dllgxhy/ble_airmouse/requirment/空中鼠标需求描述1017.pptx

## 需求描述

- 低功耗BLE蓝牙方式连接，使用标准HID接口(建议使用Nordic nRF51822)。无须驱动支持windows 8 /10 操作系统，surface 3/pro3，surface4/pro4平板电脑。
- 使用6轴传感器使用空中鼠标功能。并使用nRF51822作为传感器的信号处理MCU。
- 包含功能按键：空中鼠标模式开关，PageUp/PageDown，鼠标左键，windows快捷键组合。
- 满足50mAh的锂离子电池支持连续使用2小时的功耗要求。待机不低于180天时间。
- 蓝牙使用距离应该是在室内无遮挡不低于10米。
- 按照给定尺寸（CAD文件）的作出PCB设计，和原理图设计。

## 功能详细描述 – 用单个功能键完成多个功能

功能键：1个
休眠：静止30秒，停止陀螺仪功能。进入休眠后，必须按动功能键，才能打开陀螺仪。
已连接蓝牙情况下，功能键的定义：
1. 双击：开、关陀螺仪，此时默认鼠标左键放开状态，笔只有光标移动的功能。
2. 单击：启用、定制划线功能。
3. 长按 + 甩动：动作手势 （默认：上、下、左、右、圆弧）
动作手势：
上：空，后续跟进市场反馈添加功能
下：空，后续跟进市场反馈添加功能
左：PPT后退一页
右：PPT前进一页
圆圈：关闭投影
双色功能指示灯：1个
不亮：陀螺仪关闭
红色：固定频率闪亮，陀螺仪打开，预备移动光标功能
红色：常亮，划线功能打开
绿色：保留，我们会分配蓝牙的其他状态到绿灯上。

## 交付件

- 硬件相关：
  - 样品原型板卡
  - PCB layout设计文件
  - 原理图
  - BOM list
  - 生产 Gerber文件
- 软件相关
  - 源代码
  - 对应协议栈文件
  - 软件编译环境配置说明
  - 应用算法原理描述

## 项目计划

- 自项目正式启动，4周内给出蓝牙开发板演示原型，满足功能要求。
- 5周给PCB layout和样品板。（项目启动后一周内需求方提供结构CAD文件，并有结构工程师配合验证）
- 6周输出测试验证报告
