dllgxhy/ble_airmouse/mechnical/ble_gyro_pca_20161214/ble_gyro_pca_20161214/gyroscope_ble_pca_20161214.pptx

Gyroscope pen

蓝牙板尺寸：30*7.8*0.7mm

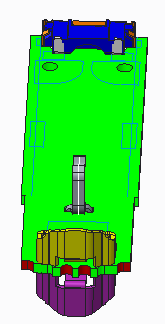
[picture p1: figure]

1. 此4个红色的凹面请覆铜，镀金，为测试机使用的测试点，
2. 烧录，测试时，拒绝在此4个点上锡，可考虑在板上别的位置再开相同的测试点，方便前期（没有测试机时），烧录，测试。

## Slide 2

Gyroscope pen

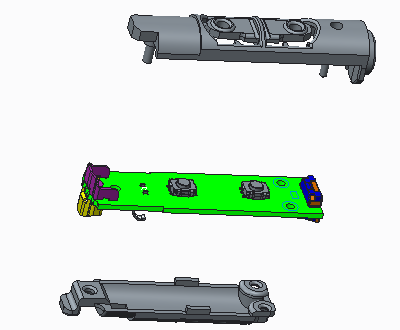
[picture p2: figure]
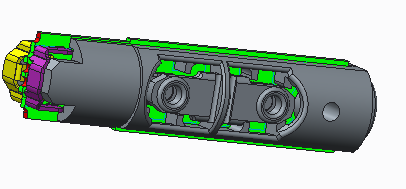
[picture p3: figure]
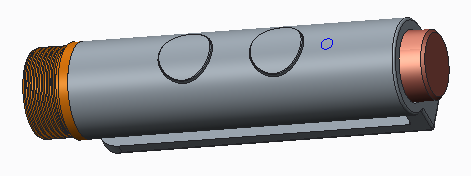
[picture p4: figure]
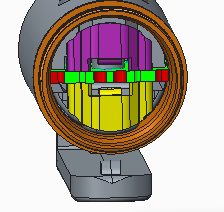
[picture p5: figure]
