dllgxhy/ble_airmouse/plan/蓝牙空鼠研发费用明细表.xls

附件：研发费用明细表
 |  | 蓝牙空鼠研发费用表
 |  | Num | Item List |  | Total Resource | Unit Price (RMB 1000 yuan) | Total Price (RMB 1000 yuan) | Resource Detail
 |  | Total | Item | Resource | 3.3 | - | 60.4 | 1 | 2 | 3 | 4 | 5 | 6 | 7 | 8 | 9 | 10 | 11 | 12
 | 设计成本 | 1 | 硬件电路设计 | 硬件工程师 | 1.10 | 18 | 19.8 |  |  |  |  |  |  |  |  |  | 0.3 | 0.8
 |  | 2 | 硬件电路设计 | PCBLayout工程师 | 0.30 | 14 | 4.2 |  |  |  |  |  |  |  |  |  |  | 0.3
 |  | 3 | 软件设计 | 嵌入式软件工程师 | 1.10 | 20 | 22 |  |  |  |  |  |  |  |  |  | 0.3 | 0.8
 |  | 4 | 软件设计 | 嵌入式软件工程师 | 0.60 | 18 | 10.8 |  |  |  |  |  |  |  |  |  | 0.3 | 0.3
 |  | 7 | Management Charge | Project Manager | 0.20 | 18 | 3.6 |  |  |  |  |  |  |  |  |  | 0.2
 |  | Num | Item List |  | Total Resource | Unit Price (RMB yuan) | Total Price (RMB yuan) |  |  |  | 费用总计 (RMB 1000 yuan)
 |  | Total | Item | Resource | 8 | - | 1645 |  |  |  | 设计费用+生产成本=61.6
 | 生产成本 （一次成本，生产5套费用） | 18 | PCB打板开板费 | PCB打板开板费 | 1 | 800 | 800
 |  | 19 | 物料成本(预估) | 物料 | 5 | 29 | 145
 |  | 20 | PCBA贴片 | PCBA贴片 | 1 | 500 | 500
 |  | 21 | 耗材 | 耗材 | 1 | 200 | 200
