dllgxhy/ble_airmouse/hardware/V10/BLEAIRNOUSE20161231坐标文件.xls

PartType | RefDes | PartDecal | Pins | Layer | Orient. | X | Y | SMD | Glued | Value
MARK | 1 | MARK | 1 | Bottom | 0 | -1.778 | 3.683 | Yes | No | None
MARK | 11 | MARK | 1 | Top | 0 | 1.778 | 3.683 | Yes | No | None
ANT_3 | ANT1 | ANT_3 | 1 | Top | 0 | 23.876 | 3.912 | Yes | No | None
C0402 | C1 | C0402B | 2 | Top | 0 | 23.622 | 0.762 | Yes | No | None
C0402 | C2 | C0402B | 2 | Top | 180 | 17.59 | 4.318 | Yes | No | None
C0402 | C3 | C0402B | 2 | Bottom | 90 | -17.018 | 4.191 | Yes | No | None
C0402 | C4 | C0402B | 2 | Bottom | 180 | -23.876 | 1.778 | Yes | No | None
C0402 | C5 | C0402B | 2 | Bottom | 90 | -19.609 | 1.27 | Yes | No | None
C0402 | C6 | C0402B | 2 | Bottom | 270 | -18.796 | 1.295 | Yes | No | None
C0402 | C7 | C0402B | 2 | Top | 180 | 16.828 | 1.448 | Yes | No | None
C0402 | C8 | C0402B | 2 | Bottom | 0 | -14.478 | 0.889 | Yes | No | None
C0402 | C9 | C0402B | 2 | Bottom | 90 | -18.796 | 2.946 | Yes | No | None
C0402 | C10 | C0402B | 2 | Top | 90 | 13.145 | 2.604 | Yes | No | None
C0402 | C11 | C0402B | 2 | Bottom | 90 | -9.652 | 2.096 | Yes | No | None
C0402 | C12 | C0402B | 2 | Top | 0 | 11.684 | 0.762 | Yes | No | None
C0402 | C13 | C0402B | 2 | Top | 90 | 24.13 | 2.032 | Yes | No | None
C0402 | C14 | C0402B | 2 | Top | 180 | 25.527 | 2.921 | Yes | No | None
C0402 | C15 | C0402B | 2 | Top | 270 | 26.035 | 4.191 | Yes | No | None
C0402 | C17 | C0402B | 2 | Top | 0 | 23.495 | 4.064 | Yes | No | None
C0402 | C18 | C0402B | 2 | Top | 90 | 6.858 | 1.27 | Yes | No | None
C0402 | C19 | C0402B | 2 | Top | 90 | 7.747 | 1.27 | Yes | No | None
C0402 | C20 | C0402B | 2 | Top | 0 | 13.589 | 4.318 | Yes | No | None
C0402 | C21 | C0402B | 2 | Top | 180 | 13.589 | 0.762 | Yes | No | None
SOD723 | D1 | SOD723 | 2 | Top | 270 | 5.969 | 1.27 | Yes | No | None
SOD723 | D2 | SOD723 | 2 | Bottom | 180 | -6.807 | 5.994 | Yes | No | None
BAT-JC | J1 | BAT-JC | 2 | Bottom | 180 | -2.972 | 3.988 | No | No | None
BAT- | J2 | BAT- | 2 | Top | 0 | 7.061 | 3.708 | No | Yes | None
BAT-JC | J3 | BAT-JC | 2 | Top | 0 | 2.972 | 3.404 | No | No | None
DIP4-2_0A | J4 | DIP4-2_0A | 4 | Top | 270 | -0.119 | 3.7 | No | No | None
L0402 | L1 | L0402B | 2 | Top | 270 | 14.034 | 2.604 | Yes | No | None
L0603 | L2 | L0603 | 2 | Top | 90 | 15.24 | 2.413 | Yes | No | None
L0402 | L3 | L0402B | 2 | Top | 270 | 25.146 | 4.191 | Yes | No | None
L0402 | L4 | L0402B | 2 | Top | 270 | 23.114 | 2.032 | Yes | No | None
L0402 | L5 | L0402B | 2 | Top | 180 | 23.495 | 3.302 | Yes | No | None
R0402 | R1 | R0402 | 2 | Top | 180 | 6.795 | 5.969 | Yes | No | None
R0402 | R2 | R0402 | 2 | Bottom | 90 | -8.763 | 3.937 | Yes | No | None
R0402 | R3 | R0402 | 2 | Bottom | 90 | -9.652 | 3.937 | Yes | No | None
R0402 | R4 | R0402 | 2 | Bottom | 270 | -8.763 | 2.083 | Yes | No | None
R0402 | R5 | R0402 | 2 | Bottom | 180 | -15.113 | 4.572 | Yes | No | None
R0402 | R6 | R0402 | 2 | Bottom | 90 | -18.034 | 4.191 | Yes | No | None
R0402 | R9 | R0402 | 2 | Bottom | 0 | -25.298 | 3.683 | Yes | No | None
R0402 | R10 | R0402 | 2 | Bottom | 0 | -25.298 | 2.794 | Yes | No | None
R0402 | R11 | R0402 | 2 | Bottom | 180 | -25.298 | 4.572 | Yes | No | None
R0402 | R12 | R0402 | 2 | Bottom | 0 | -15.113 | 2.794 | Yes | No | None
R0402 | R13 | R0402 | 2 | Bottom | 180 | -15.113 | 3.683 | Yes | No | None
R0402 | R15 | R0402 | 2 | Bottom | 0 | -23.876 | 0.813 | Yes | No | None
SW-3_5X2_7-SMD | SW1 | SW-3_5X2_7-SMD | 6 | Bottom | 0 | -12.195 | 3.723 | Yes | Yes | None
SW-3_5X2_7-SMD | SW2 | SW-3_5X2_7-SMD | 6 | Bottom | 180 | -21.695 | 3.728 | Yes | Yes | None
EVQP4 | SW3 | EVQP4 | 4 | Top | 90 | 27.203 | 3.708 | Yes | Yes | None
TP-1MM | TP1 | TP-1MMB | 1 | Bottom | 0 | -11.735 | 0.279 | Yes | No | None
TP-1MM | TP2 | TP-1MMB | 1 | Bottom | 0 | -9.716 | 0.279 | Yes | No | None
TP-1MM | TP3 | TP-1MMB | 1 | Bottom | 0 | -10.719 | 0.279 | Yes | No | None
TP-1MM | TP4 | TP-1MMB | 1 | Bottom | 0 | -12.764 | 0.279 | Yes | No | None
TP-1MM | TP7 | TP-1MMB | 1 | Bottom | 0 | -7.214 | 6.795 | Yes | No | None
TP-1MM | TP8 | TP-1MMB | 1 | Bottom | 0 | -2.794 | 6.807 | Yes | No | None
TP-1MM | TP9 | TP-1MMB | 1 | Bottom | 0 | -1.524 | 6.795 | Yes | No | None
TP-1MM | TP13 | TP-1MMB | 1 | Bottom | 0 | -2.794 | 0.635 | Yes | No | None
TP-1MM | TP14 | TP-1MMB | 1 | Bottom | 0 | -1.524 | 0.635 | Yes | No | None
TP-1MM | TP15 | TP-1MMAA | 1 | Top | 0 | 19.368 | 0.191 | Yes | No | None
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
 |  |  |  |  |  | 0
 |  |  |  |  |  | 0
 |  |  |  |  |  | 0
 |  |  |  |  |  | 0
 |  |  |  |  |  | 0
 |  |  |  |  |  | 0
 |  |  |  |  |  | 0
 |  |  |  |  |  | 0
 |  |  |  |  |  | 0
 |  |  |  |  |  | 0
 |  |  |  |  |  | 0
 |  |  |  |  |  | 0
 |  |  |  |  |  | 0
 |  |  |  |  |  | 0
