dllgxhy/ble_airmouse/hardware/V10/ble_gyro_pca20161231a.dxf

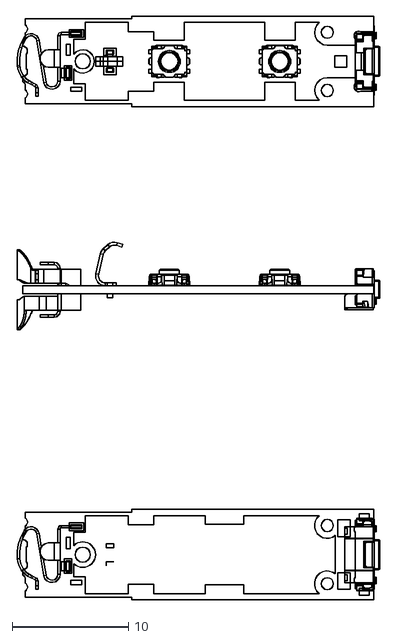
[picture p14: CAD file, 2016-12-31]
hardware/V10/ble_gyro_pca20161231a.dxf
31.3 x 50.2
