dllgxhy/ble_airmouse/mechnical/ble_gyro_pca_20161214/ble_gyro_pca_20161214/ble_gyro_pca_outline.dxf

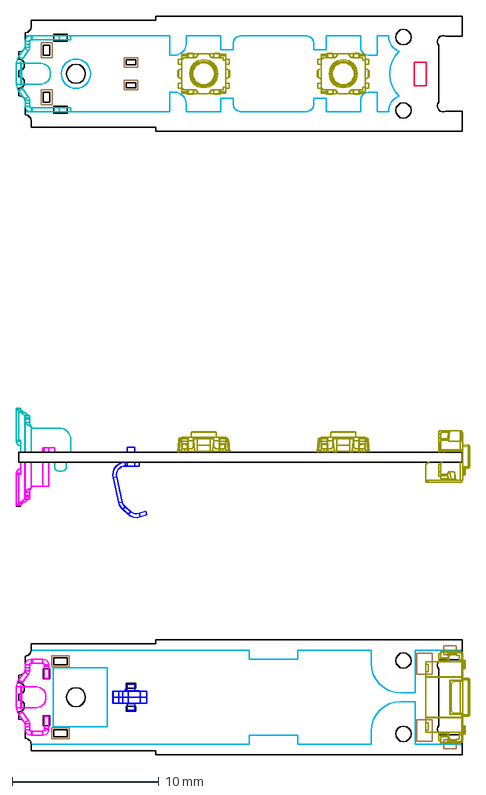
[picture p15: CAD file, 2017-02-14]
mechnical/ble_gyro_pca_20161214/ble_gyro_pca_20161214/ble_gyro_pca_outline.dxf
30.9 x 50.2 mm
