dllgxhy/ble_airmouse/mechnical/ble_gyro_pca_20161229/ble_gyro_pca_20161229/ble_gyro_pca20161225.dxf

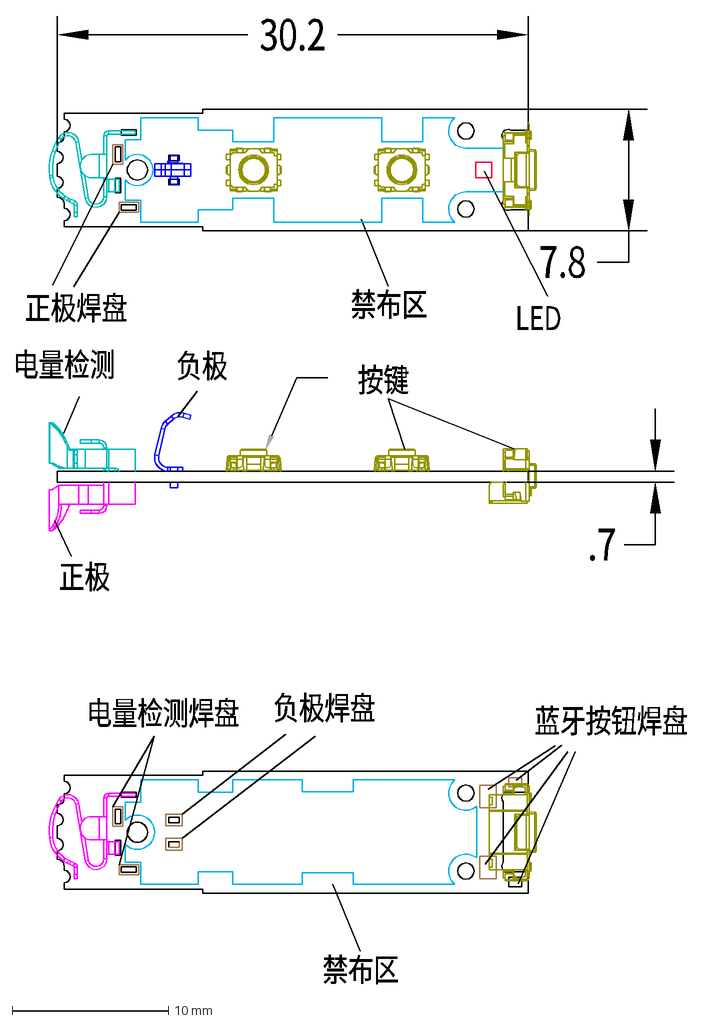
[picture p16: CAD file, 2016-12-25]
mechnical/ble_gyro_pca_20161229/ble_gyro_pca_20161229/ble_gyro_pca20161225.dxf
30.2
7.8
.7
正极焊盘
负极焊盘
LED
禁布区
按键
电量检测
正极
负极
电量检测焊盘
蓝牙按钮焊盘
