dllgxhy/ble_airmouse/mechnical/ble_gyro_pca_20161214/ble_gyro_pca_20161214/ble_gyro_pca_outline-02.dxf

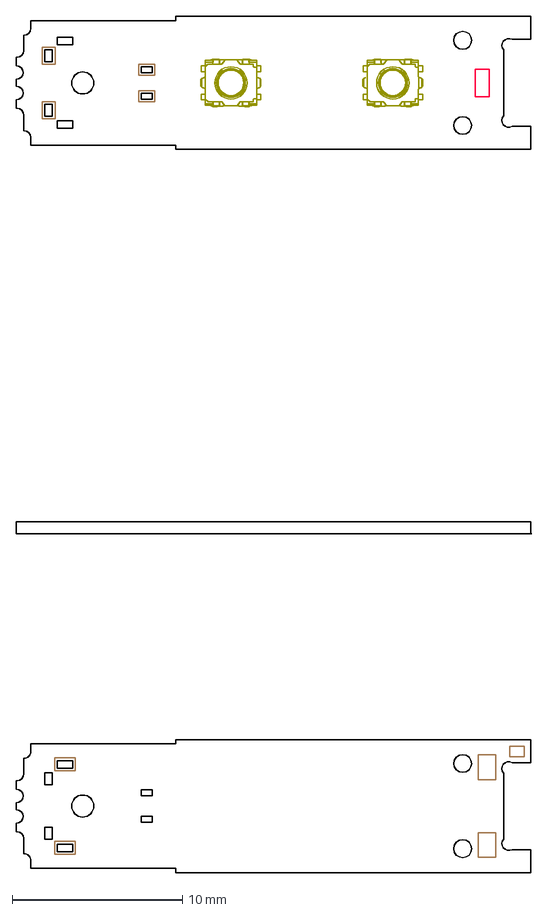
[picture p17: CAD file, 2017-02-14]
mechnical/ble_gyro_pca_20161214/ble_gyro_pca_20161214/ble_gyro_pca_outline-02.dxf
30.3 x 50.2 mm
