dllgxhy/ble_airmouse/mechnical/ble_gyro_pca_20161214/ble_gyro_pca_20161214/ble_gyro_pca.dxf

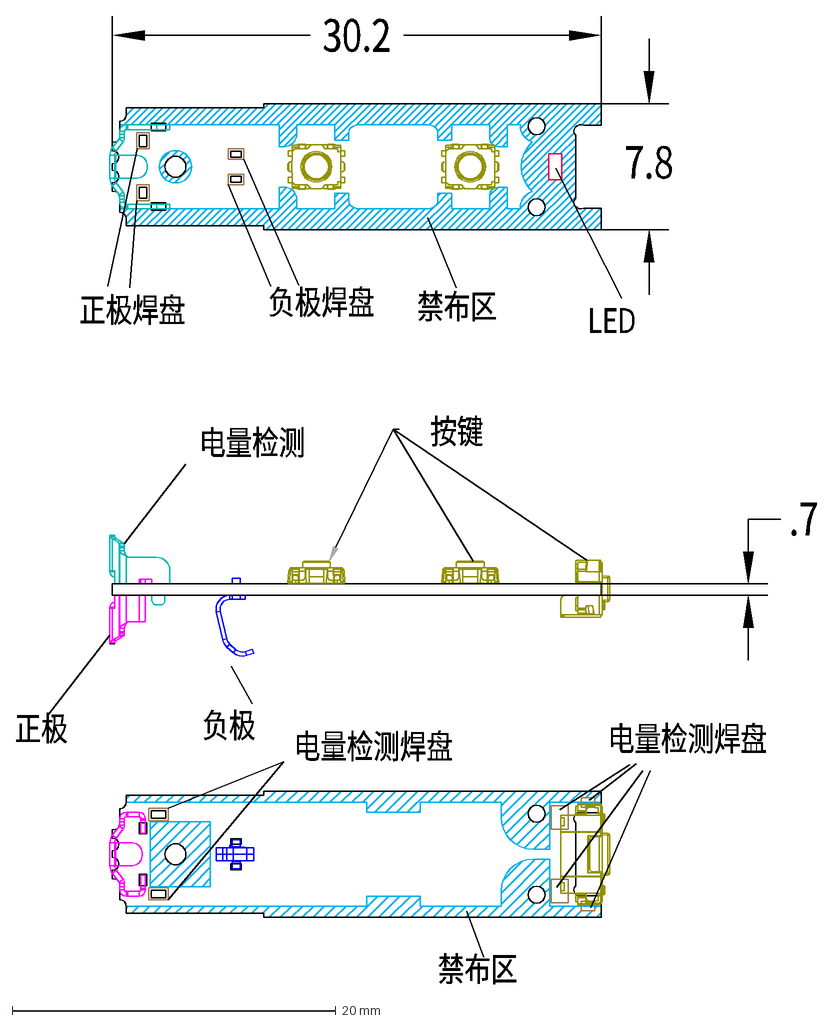
[picture p18: CAD file, 2017-02-14]
mechnical/ble_gyro_pca_20161214/ble_gyro_pca_20161214/ble_gyro_pca.dxf
30.2
7.8
.7
按键
电量检测
正极
负极
正极焊盘
负极焊盘
电量检测焊盘
LED
禁布区
