dllgxhy/ble_airmouse/(list of files, cad)

Other CAD files:
datasheet/component_data_sheet/positive_plate_ble.dwg
datasheet/component_data_sheet/signal_plate_ble.dwg
