dllgxhy/ble_airmouse/hardware/BAK/20161230/BLEAIRNOUSE20161230/bleairnouse_20161230_v1.pdf

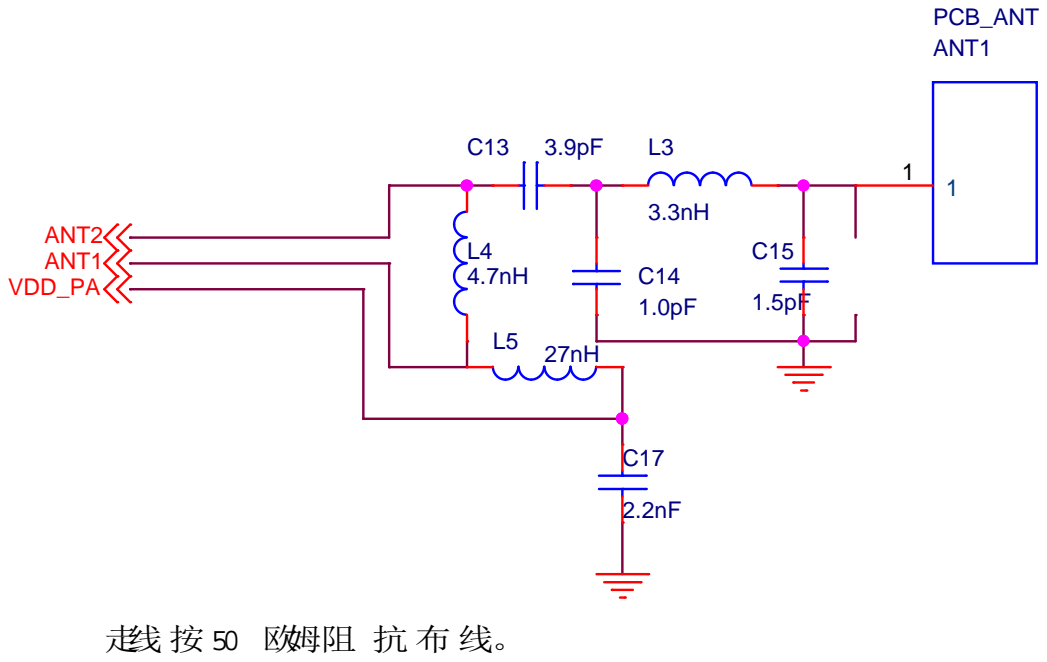
[picture p19: page 1]
走线按50 欧姆阻 抗布 线。; ANT2 ANT1 VDD_PA; ANT1; PCB_ANT

## 陀螺仪+加速 度计

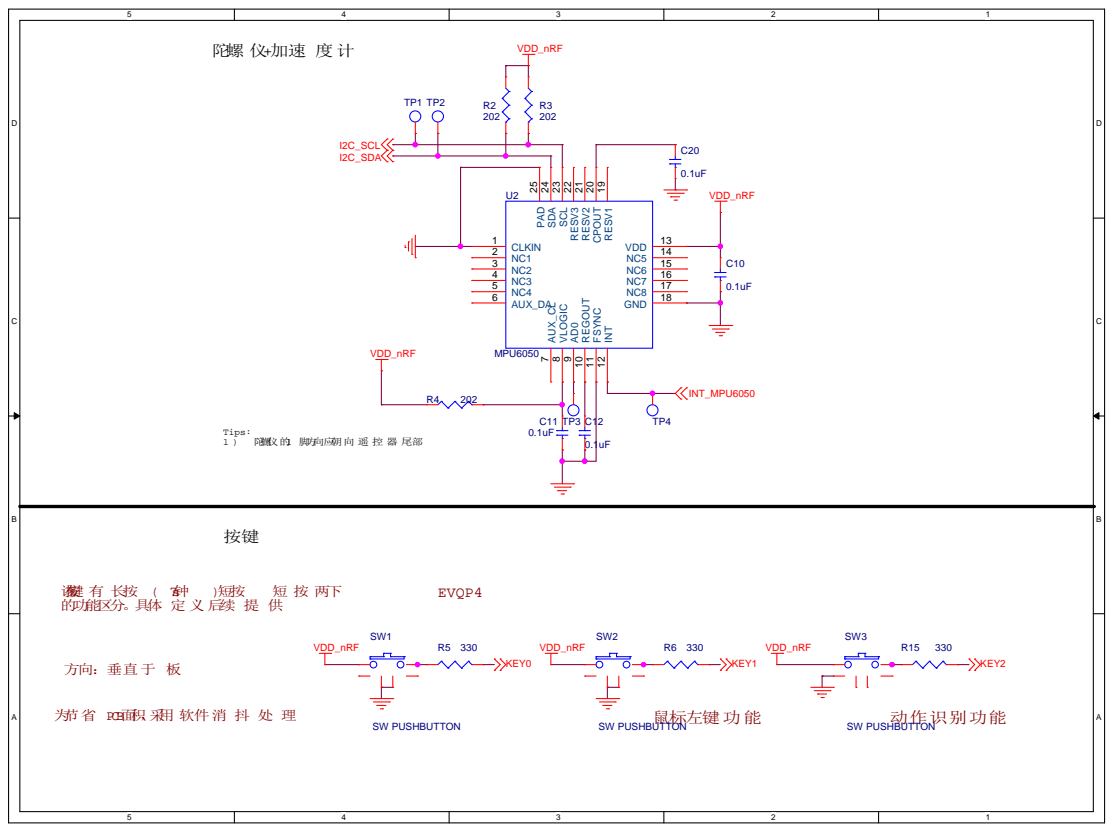
[picture p20: page 2]

的功能区分。具体 定义 后续 提供

# 20161 224 更改内容：

## 1 ） 删除一个按键， 更改为 总数为 2个按键

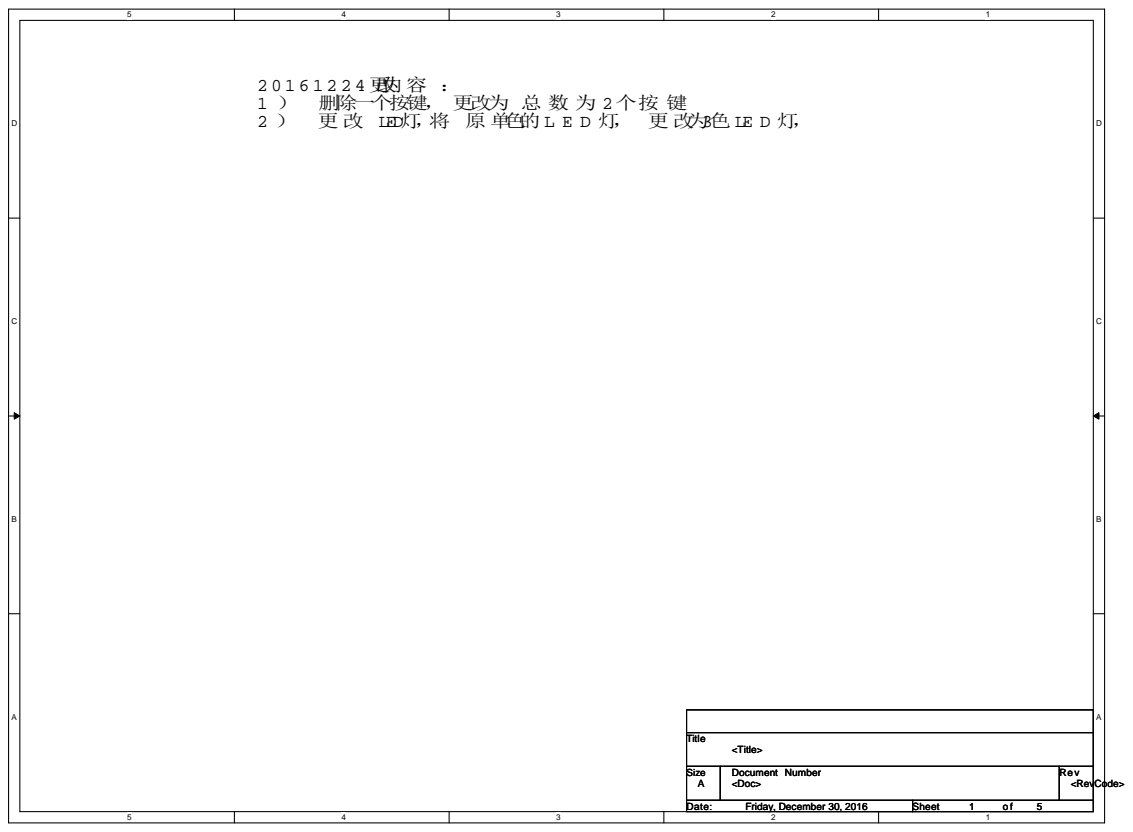
[picture p21: page 3]
Title; Size; Document Number; Rev; Date:; Sheet; <Doc>; <RevCode>; <Title>; Friday, December 30, 2016

2 ） 更改 LED灯，将 原 单色的 LED 灯， 更 改为3色 LED 灯，

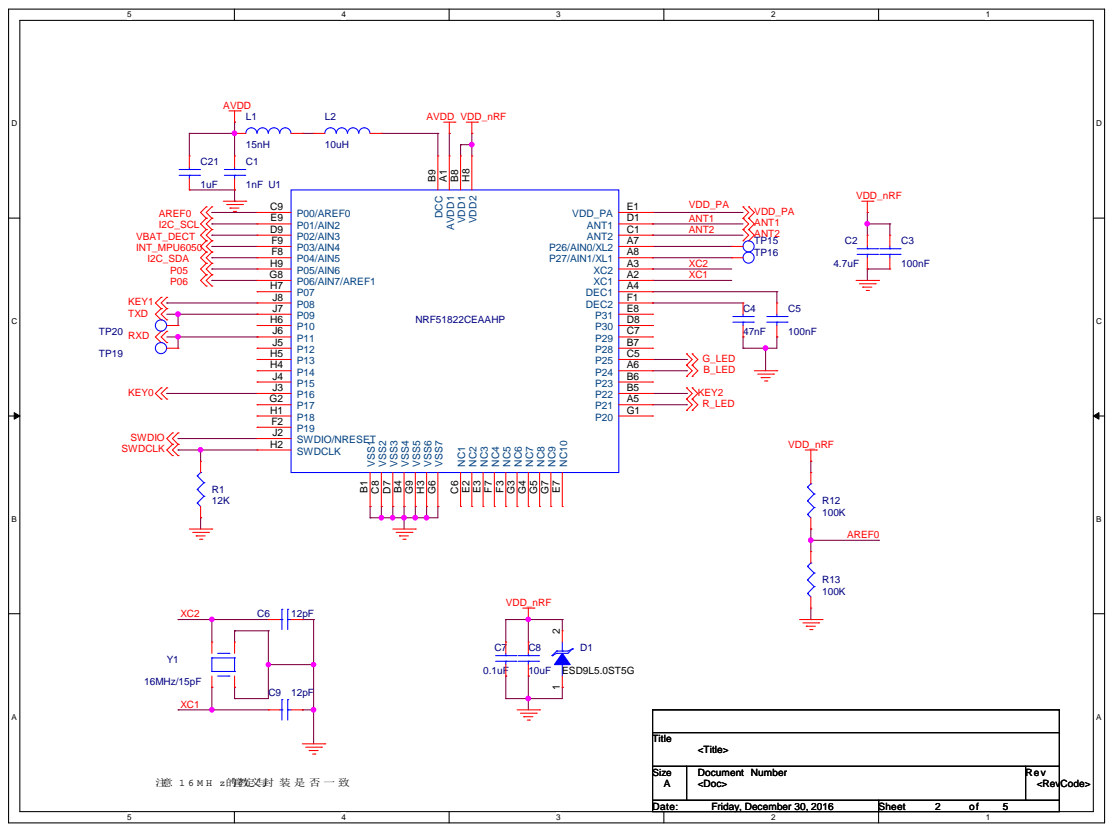
[picture p22: page 4]

## 供电接口

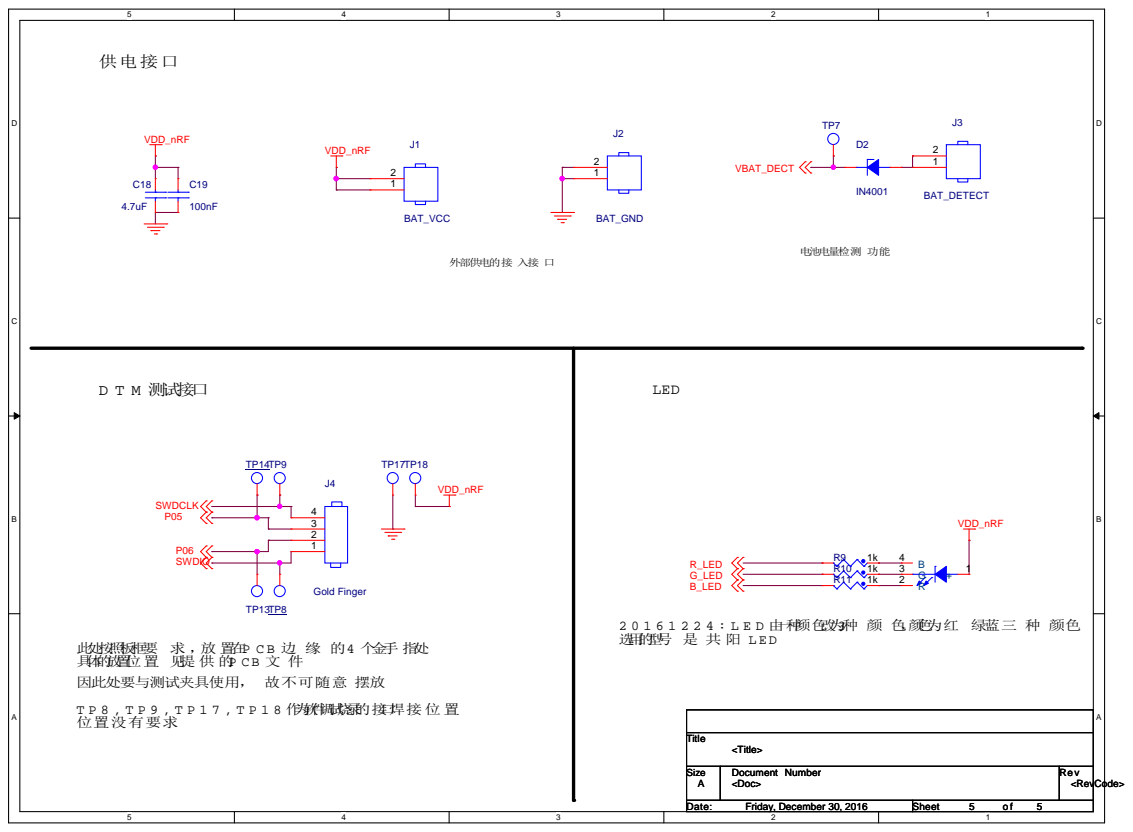
[picture p23: page 5]

201 61224:LED 由一种颜色改为3种颜 色，颜色为红 绿蓝三 种颜色
选用的型号 是 共阳 LED

此处按照板框要求 ，放 置在P CB 边缘 的4 个金手指处
具体的放置位置见提供的P CB 文 件
因此处要与测试夹具使用， 故不可随意 摆放
TP8,TP9,TP17,TP18 作为软件调试烧录的接口焊接位置
位置没有要求
