dllgxhy/ble_airmouse/plan/蓝牙空鼠.pdf

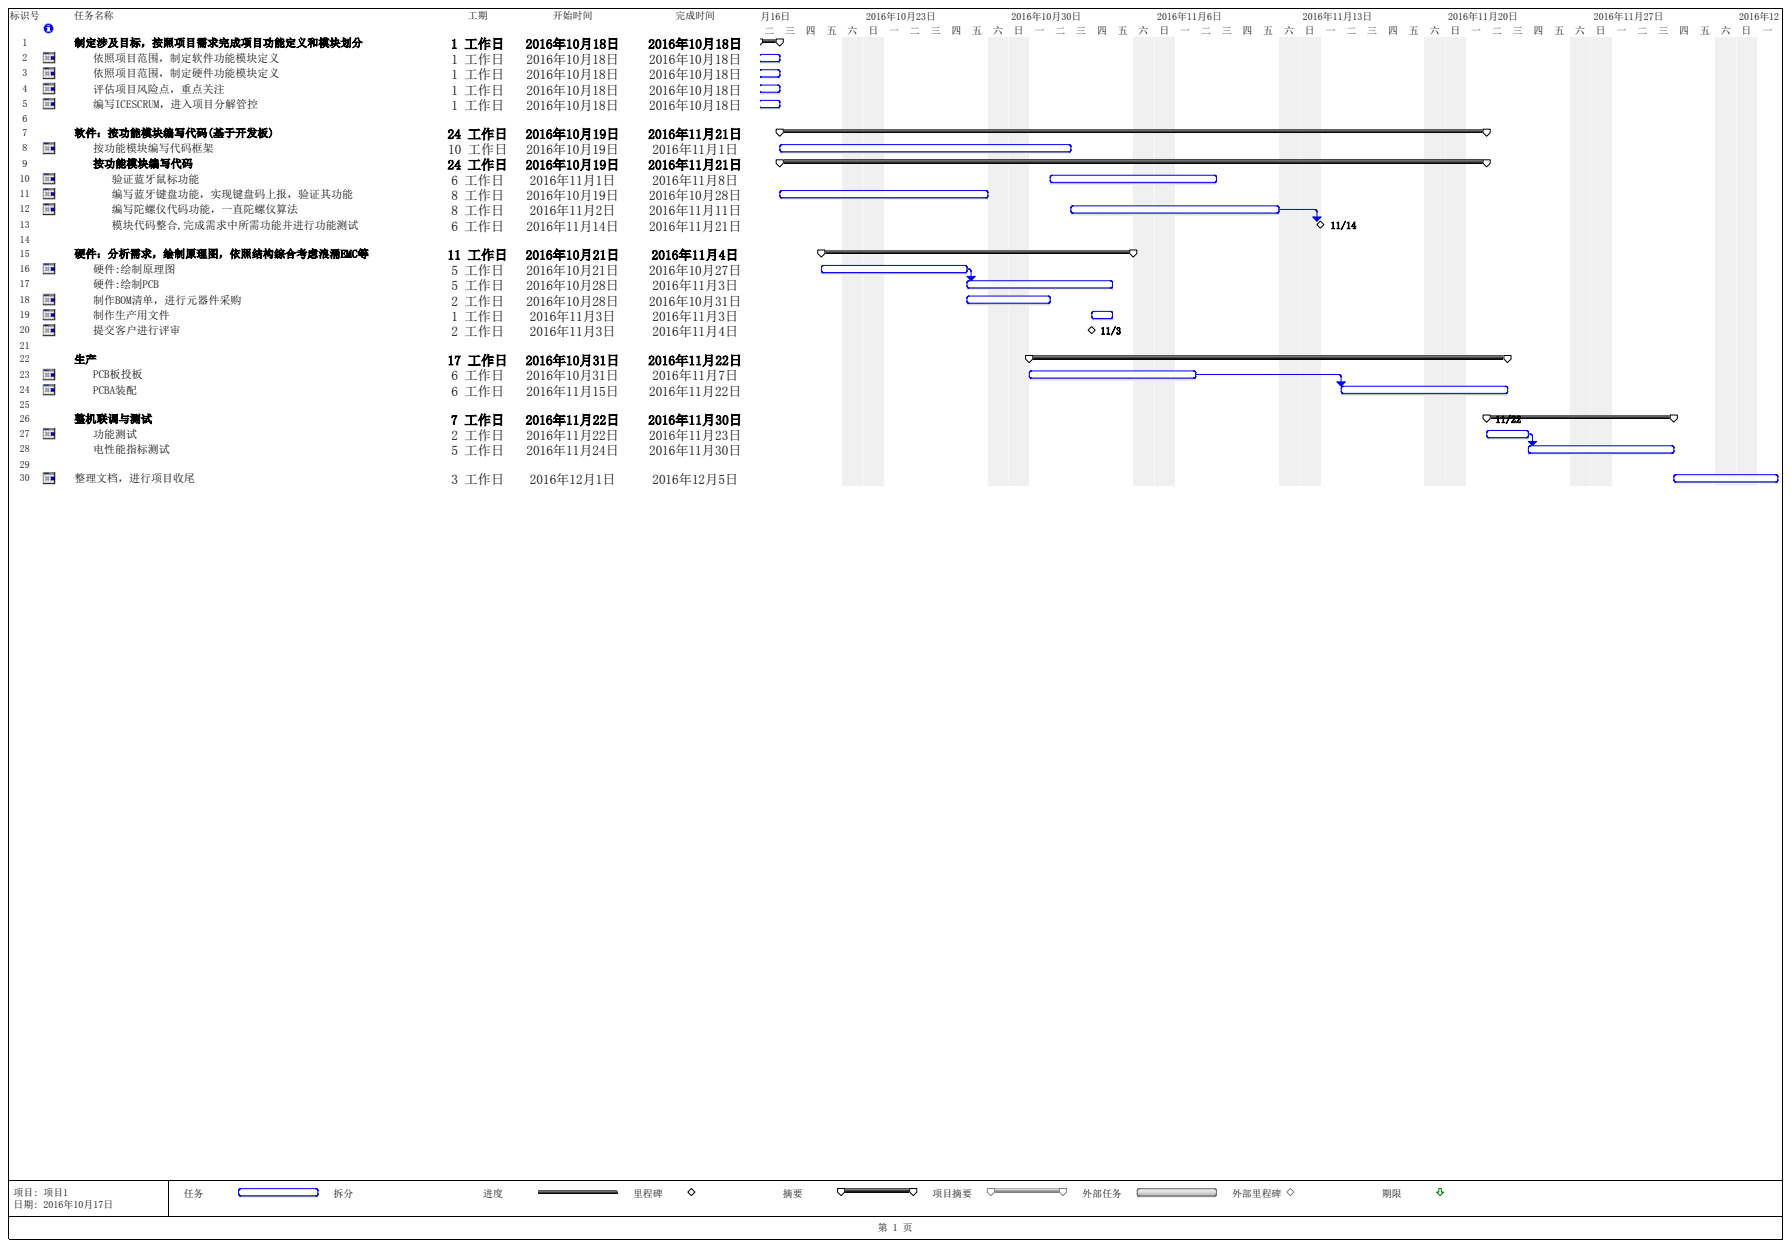
[picture p24: page 1]
标识号; 任务名称; 开始时间; 完成时间; 制定涉及目标，按照项目需求完成项目功能定义和模块划分; 1 工作日; 依照项目范围，制定软件功能模块定义; 依照项目范围，制定硬件功能模块定义; 评估项目风险点，重点关注; 编写ICESCRUM，进入项目分解管控; 软件：按功能模块编写代码(基于开发板); 24 工作日; 按功能模块编写代码框架; 10 工作日; 按功能模块编写代码; 验证蓝牙鼠标功能; 6 工作日; 编写蓝牙键盘功能，实现键盘码上报，验证其功能; 8 工作日; 编写陀螺仪代码功能，一直陀螺仪算法; 模块代码整合,完成需求中所需功能并进行功能测试; 硬件：分析需求，绘制原理图，依照结构综合考虑浪涌EMC等; 11 工作日; 硬件:绘制原理图; 5 工作日; 硬件:绘制PCB; 制作BOM清单，进行元器件采购; 2 工作日; 制作生产用文件; 提交客户进行评审; 17 工作日; PCB板投板; PCBA装配; 整机联调与测试; 7 工作日; 功能测试; 电性能指标测试; 整理文档，进行项目收尾; 3 工作日; 里程碑; 项目摘要; 外部任务; 外部里程碑
