dllgxhy/ble_airmouse/document/BLE_Prints0730.pdf

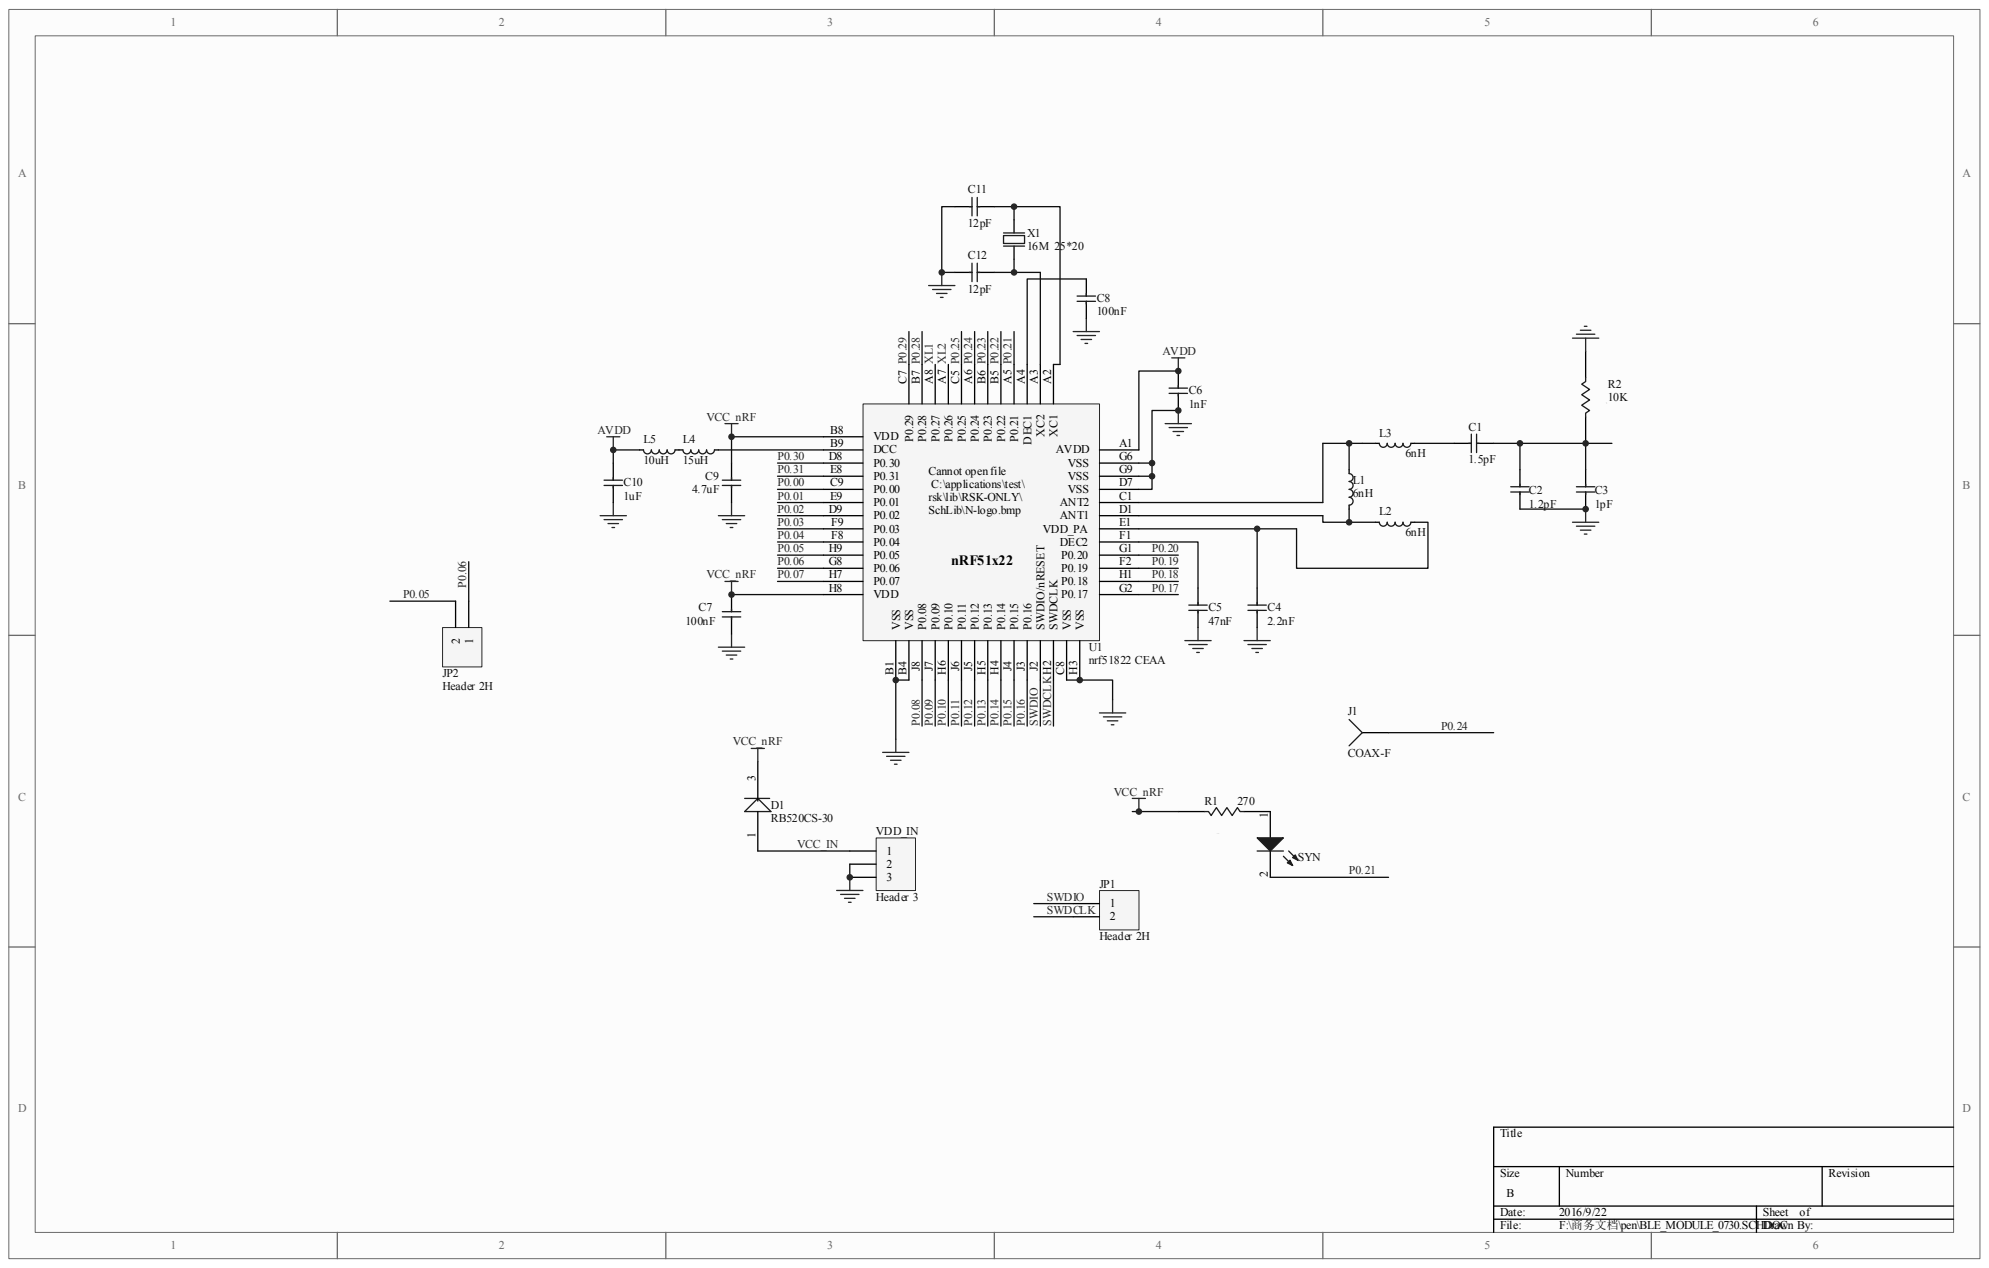
[picture p25: page 1]

Cannot open file
C:\applications\test\
rsk\lib\RSK-ONLY\
SchLib\N-logo.bmp
