dllgxhy/ble_airmouse/hardware/V10/BLEAIRNOUSE20161231装配图.pdf

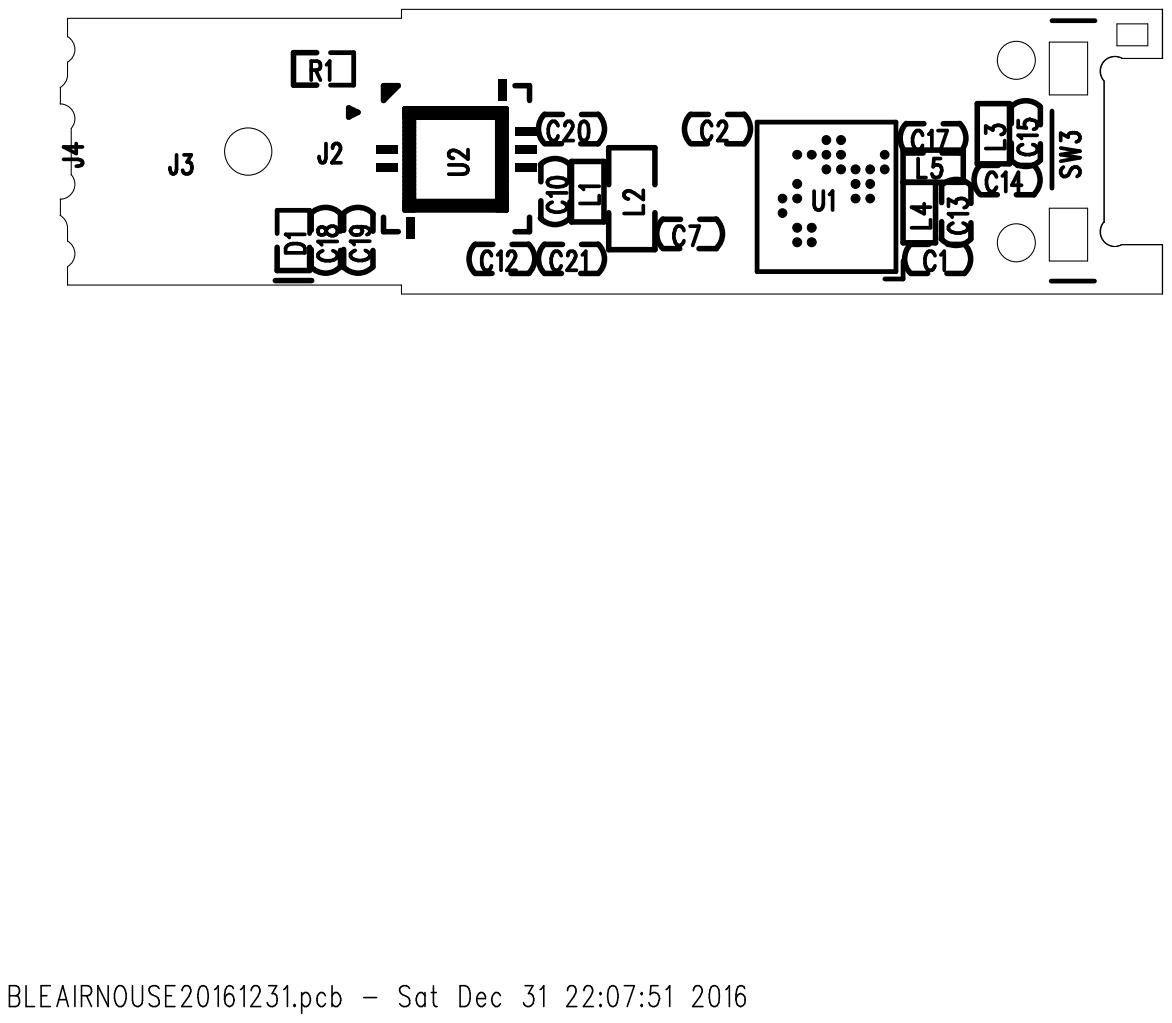
[picture p26: page 1]

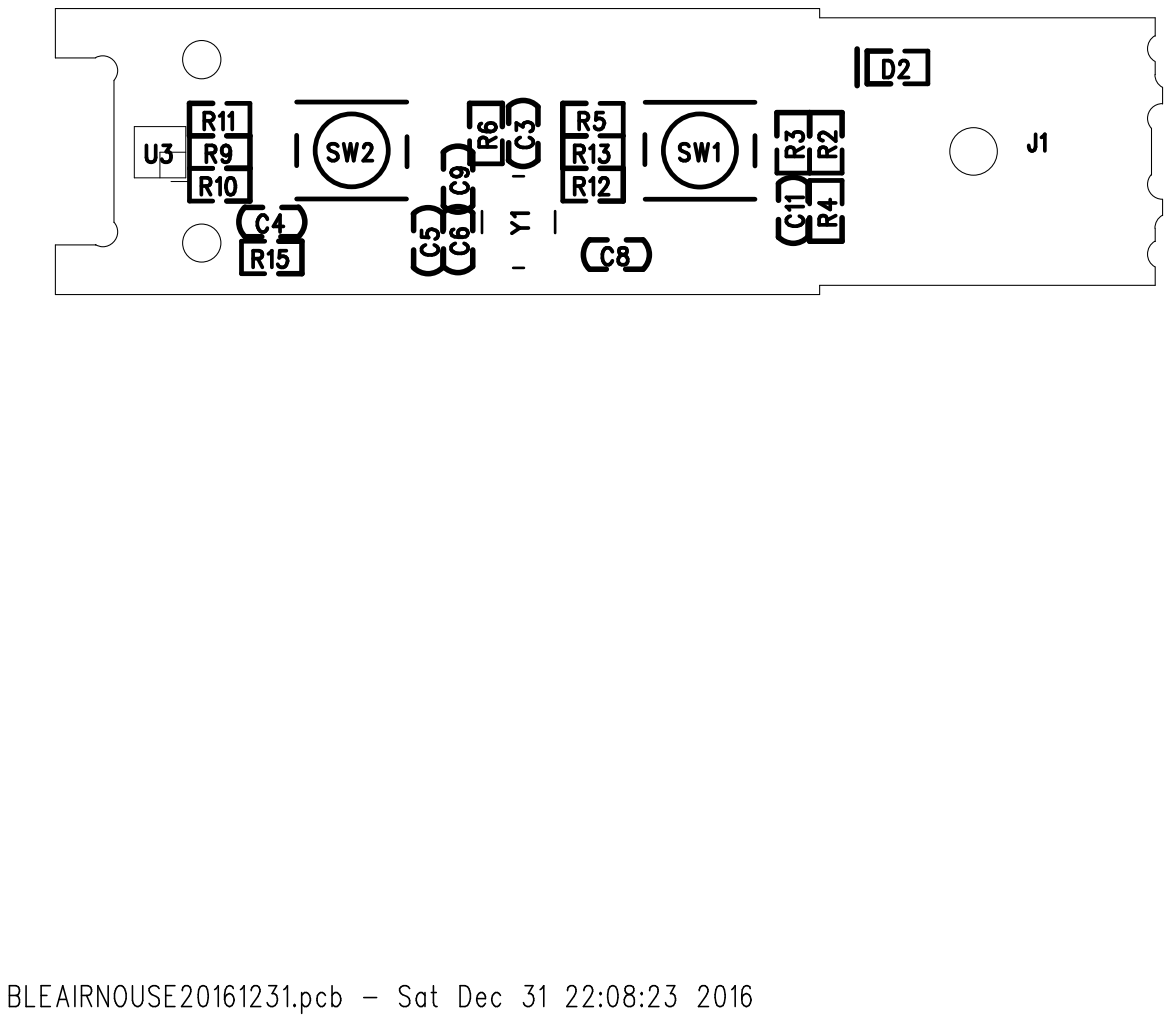
[picture p27: page 2]
