dllgxhy/ble_airmouse/mechnical/ble_gyro_pca_20161214/ble_gyro_pca_20161214/ble_gyro_pca.pdf

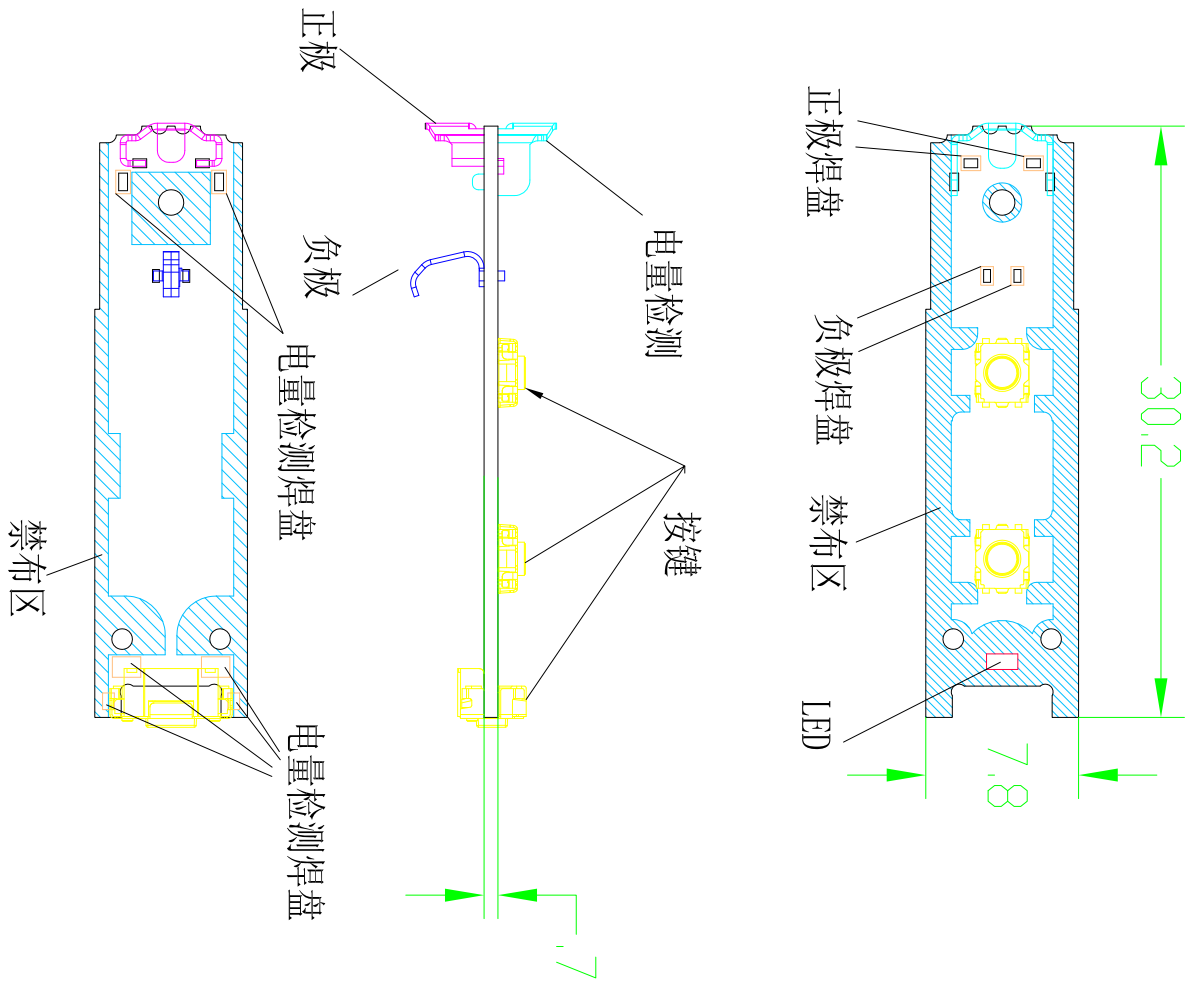
[picture p28: page 1]
