dllgxhy/ble_airmouse/(list of files, drawings)

Other design files:
document/BLE_module_0730.PCBDOC
hardware/BAK/20151227/BLEAIRNOUSE/BLEAIRNOUSE20161220.pcb
hardware/BAK/20151227/BLEAIRNOUSE/BLEAIRNOUSE20161227-AD.PcbDoc
hardware/BAK/20151227/BLEAIRNOUSE/BLEAIRNOUSE20161227.pcb
hardware/BAK/20151227/BLEAIRNOUSE/BLEAIRNOUSE_20161215_V3.DSN
hardware/BAK/20151227/BLEAIRNOUSE/BLEAIRNOUSE_20161225_V1.DSN
hardware/BAK/20151227/BLEAIRNOUSE/bleairnouse_20161225_v1.opj
hardware/BAK/20161225/BLEAIRNOUSE20161225.pcb
hardware/BAK/20161225/bleairnouse_20161215_v3.opj
hardware/BAK/20161225/BLEAIRNOUSE_20161225_V1.DSN
hardware/BAK/20161225/bleairnouse_20161225_v1.opj
hardware/BAK/20161228/BLEAIRNOUSE20161228-1.pcb
hardware/BAK/20161229/BLEAIRNOUSE20161229/BLEAIRNOUSE20161229.pcb
hardware/BAK/20161229/BLEAIRNOUSE20161229/BLEAIRNOUSE_20161225_V1.DSN
hardware/BAK/20161229/BLEAIRNOUSE20161229/bleairnouse_20161225_v1.opj
hardware/BAK/20161230/BLEAIRNOUSE20161230/BLEAIRNOUSE20161230.pcb
hardware/BAK/20161230/BLEAIRNOUSE20161230/BLEAIRNOUSE_20161230_V1.DSN
hardware/BAK/20161230/BLEAIRNOUSE20161230/bleairnouse_20161230_v1.opj
hardware/V10/BLEAIRNOUSE20161231.pcb
hardware/V10/BLEAIRNOUSE_20161230_V1.DSN
hardware/V10/bleairnouse_20161230_v1.opj
