dllgxhy/ble_airmouse/(commit log)

2016-10-18 蓝牙空鼠首次提交
    [BLEAIRNOUSE.DSN, bleairnouse.opj, bleairnouse.pcb, 蓝牙空鼠研发费用明细表.xls]
2016-11-09 离职前整理
    [BLEAIRNOUSE.DSN, bleairnouse.opj]
2016-12-14 凌总提供完首次定金后提交
    [BLEAIRNOUSE.DSN, bleairnouse.opj, outline.dwg, 蓝牙空鼠研发费用明细表.xls]
2016-12-14 更新硬件原理图
    [BLEAIRNOUSE.DSN, LIBRARY.OLB, bleairnouse.opj]
2016-12-25 添加新文件
    [BLEAIRNOUSE.DSN, BLEAIRNOUSE20161220.pcb, BLEAIRNOUSE20161225.pcb, BLEAIRNOUSE_20161225_V1.DSN, BLE_AIRMOUSE_BOM_V10.xls, BLE_module_0730.PCBDOC, LIBRARY.OLB, ble_gyro_pca20161225.dxf]
2016-12-31 提交凌总版本 硬件资料为20161231文件夹内，BOM采购OK，但是LED灯的限流电阻要和小何再确认下
    [BLEAIRNOUSE20161220.pcb, BLEAIRNOUSE20161227-AD.PcbDoc, BLEAIRNOUSE20161227.pcb, BLEAIRNOUSE20161228-1.pcb, BLEAIRNOUSE20161229.pcb, BLEAIRNOUSE20161230.pcb, BLEAIRNOUSE20161231.pcb, BLEAIRNOUSE20161231坐标文件.xls]
2017-02-14 最终版本提交
    [BLEAIRNOUSE20161220.pcb, BLEAIRNOUSE20161225.pcb, BLEAIRNOUSE20161227-AD.PcbDoc, BLEAIRNOUSE20161227.pcb, BLEAIRNOUSE20161228-1.pcb, BLEAIRNOUSE20161229.pcb, BLEAIRNOUSE20161230.pcb, BLEAIRNOUSE20161231.pcb]
